JesseYan8/LPDA/LPDA_Mount_V1_3_Hybrid_P2S/LPDA_Mount_V1_3_Hybrid/OPTIONAL_TPU/README_zh.md

仅是软垫的可选制造方式，可用尺寸相同的柔软硅胶片替代。
不要用PETG打印这些软垫。尼龙M3螺钉、螺母、垫圈必须使用购买的成品，不属于这组文件。
S01×8，S02×4，S03×16，S04×4。打印软垫未做实际验证。
