JesseYan8/LPDA/LPDA_Mount_V1_3_Hybrid_P2S/LPDA_Mount_V1_3_Hybrid/preview/01_structure.png

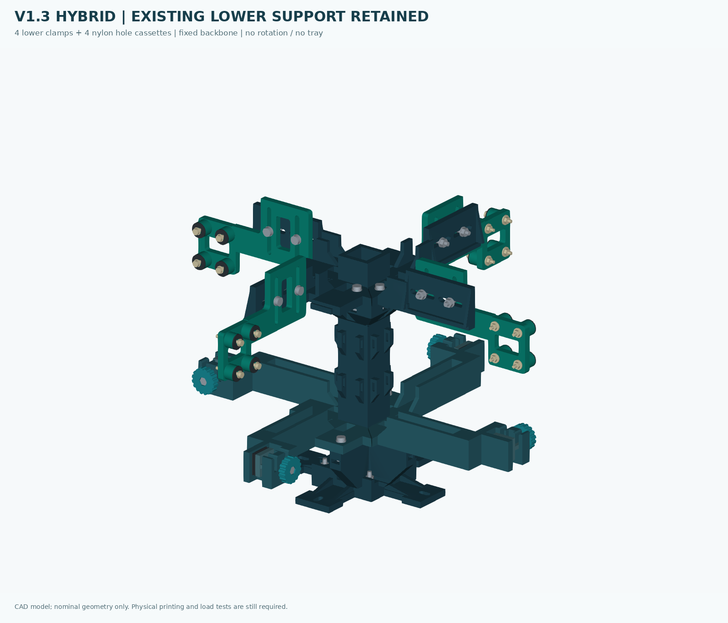
LPDA_Mount_V1_3_Hybrid_P2S/LPDA_Mount_V1_3_Hybrid/preview/01_structure.png
