JesseYan8/LPDA/LPDA_Mount_V1_3_Hybrid_P2S/LPDA_Mount_V1_3_Hybrid/preview/03_single_sector.png

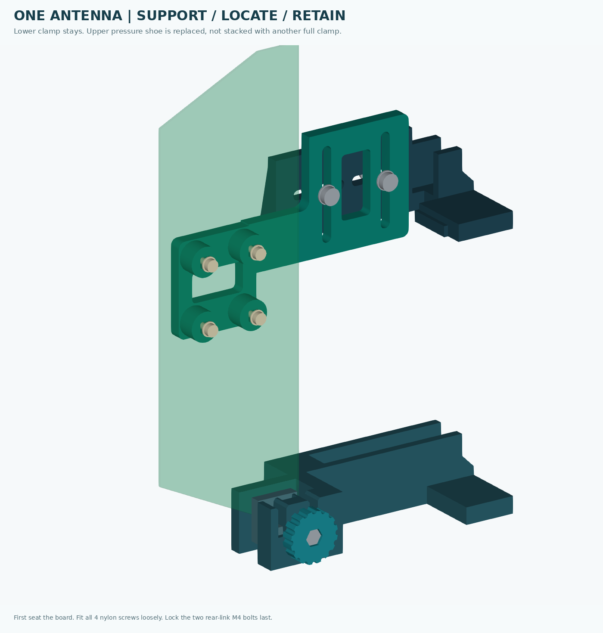
LPDA_Mount_V1_3_Hybrid_P2S/LPDA_Mount_V1_3_Hybrid/preview/03_single_sector.png
