JesseYan8/LPDA/LPDA_Mount_V1_3_Hybrid_P2S/LPDA_Mount_V1_3_Hybrid/preview/05_cassette_face.png

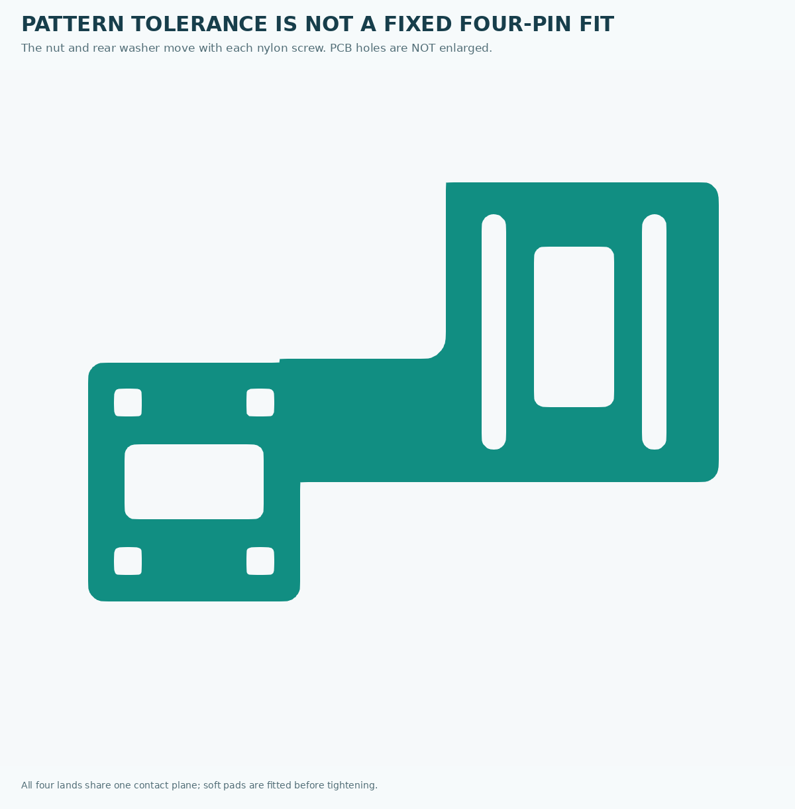
LPDA_Mount_V1_3_Hybrid_P2S/LPDA_Mount_V1_3_Hybrid/preview/05_cassette_face.png
