JesseYan8/LPDA/LPDA_Mount_V1_3_Hybrid_P2S/LPDA_Mount_V1_3_Hybrid/preview/FULL_01_LOWER_REUSED.png

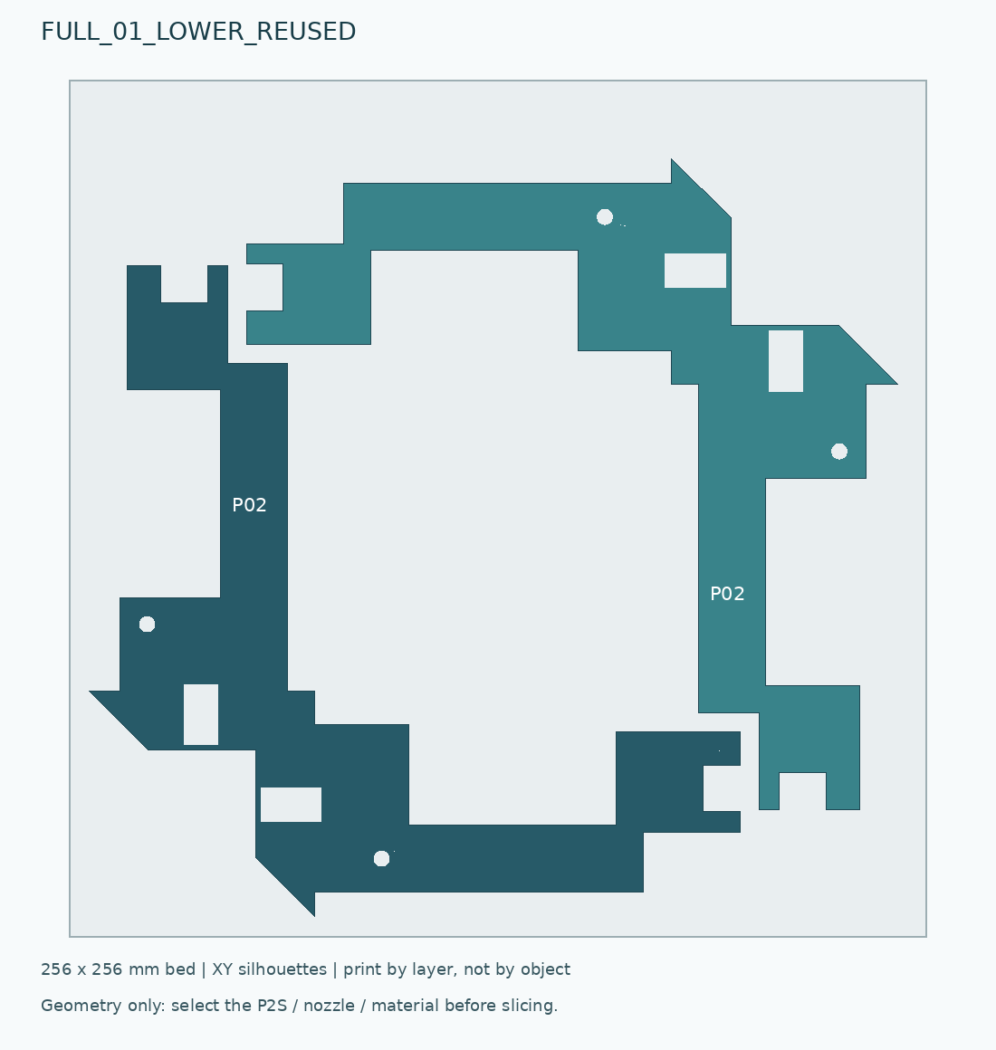
LPDA_Mount_V1_3_Hybrid_P2S/LPDA_Mount_V1_3_Hybrid/preview/FULL_01_LOWER_REUSED.png
