JesseYan8/LPDA/LPDA_Mount_V1_3_Hybrid_P2S/LPDA_Mount_V1_3_Hybrid/preview/FULL_03_REUSED_MAST_BASE_SMALL.png

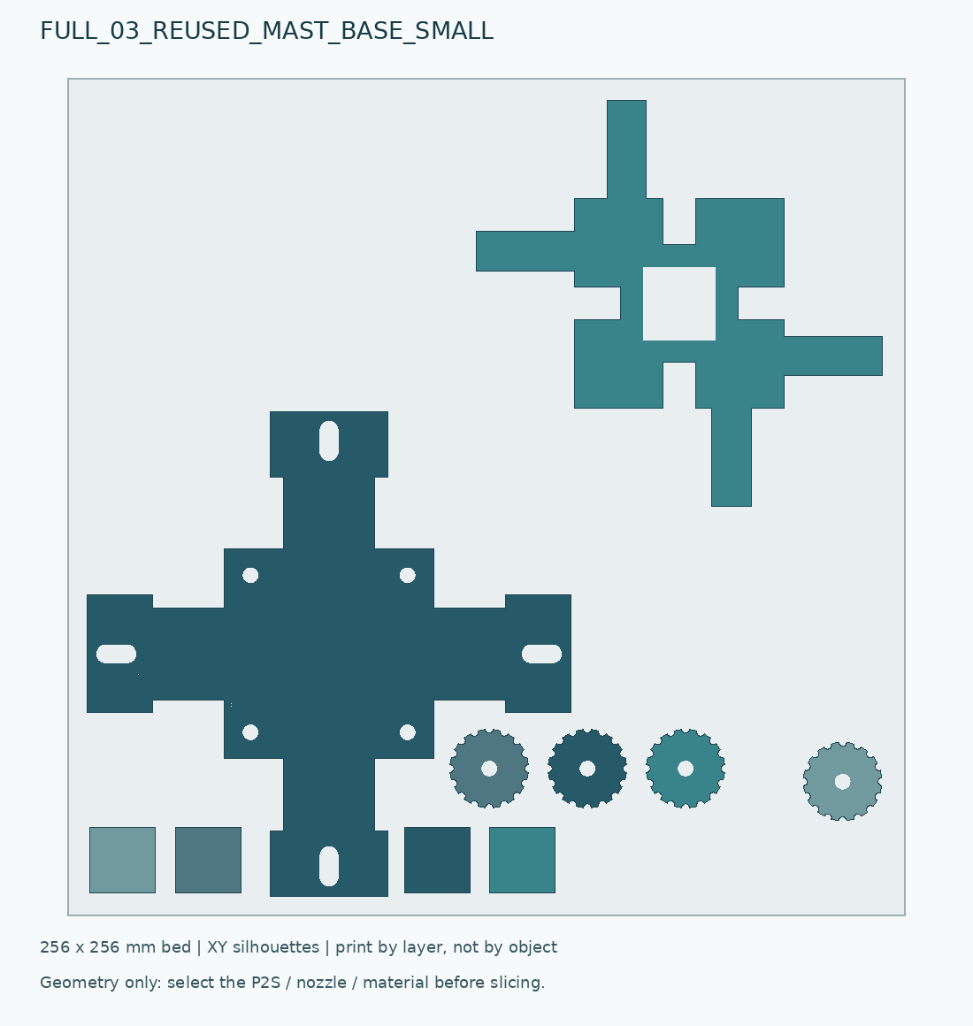
LPDA_Mount_V1_3_Hybrid_P2S/LPDA_Mount_V1_3_Hybrid/preview/FULL_03_REUSED_MAST_BASE_SMALL.png
