JesseYan8/LPDA/LPDA_Mount_V1_3_Hybrid_P2S/LPDA_Mount_V1_3_Hybrid/plates/FULL_02_UPPER.3mf

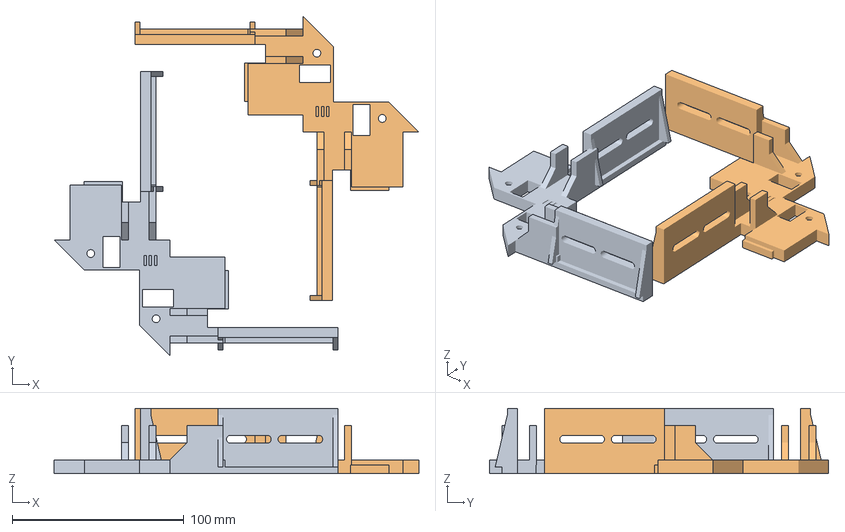
[picture p10: CAD file, 2026-09-13]
LPDA_Mount_V1_3_Hybrid_P2S/LPDA_Mount_V1_3_Hybrid/plates/FULL_02_UPPER.3mf
212.4 x 197.4 x 38.0 mm
P01_upper_carrier_1
P01_upper_carrier_2
