JesseYan8/LPDA/LPDA_Mount_V1_3_Hybrid_P2S/LPDA_Mount_V1_3_Hybrid/plates/FULL_04_CASSETTES.3mf

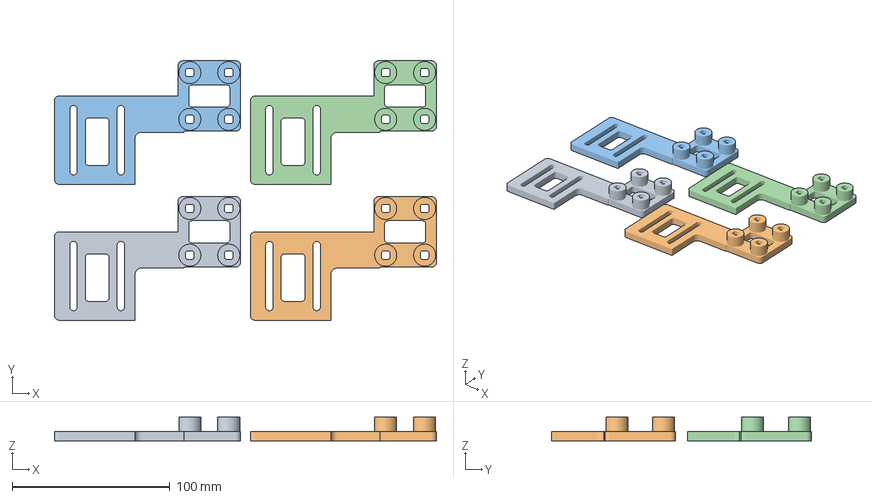
[picture p11: CAD file, 2026-09-13]
LPDA_Mount_V1_3_Hybrid_P2S/LPDA_Mount_V1_3_Hybrid/plates/FULL_04_CASSETTES.3mf
241.8 x 164.3 x 15.0 mm
P07_four_hole_cassette_1
P07_four_hole_cassette_2
P07_four_hole_cassette_3
P07_four_hole_cassette_4
