JesseYan8/LPDA/LPDA_Mount_V1_3_Hybrid_P2S/LPDA_Mount_V1_3_Hybrid/plates/FULL_03_REUSED_MAST_BASE_SMALL.3mf

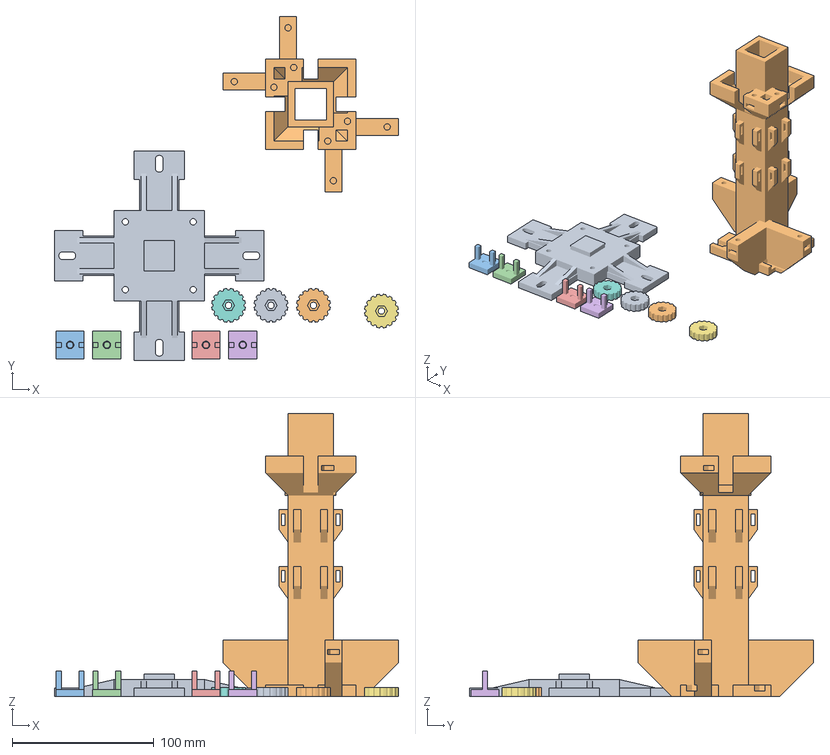
[picture p12: CAD file, 2026-09-13]
LPDA_Mount_V1_3_Hybrid_P2S/LPDA_Mount_V1_3_Hybrid/plates/FULL_03_REUSED_MAST_BASE_SMALL.3mf
243.0 x 243.0 x 200.0 mm
P04_anchor_base_1
P03_fixed_mast_1
P05_pressure_shoe_1
P05_pressure_shoe_2
P05_pressure_shoe_3
P05_pressure_shoe_4
P06_M4_knob_1
P06_M4_knob_2
P06_M4_knob_3
P06_M4_knob_4
