JesseYan8/LPDA/LPDA_Mount_V1_3_Hybrid_P2S/LPDA_Mount_V1_3_Hybrid/plates/FULL_01_LOWER_REUSED.3mf

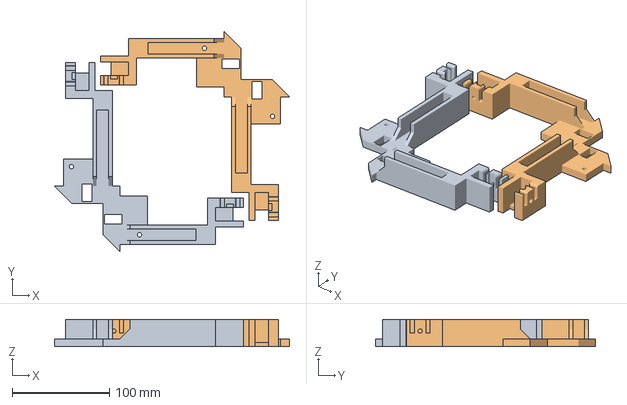
[picture p13: CAD file, 2026-09-13]
LPDA_Mount_V1_3_Hybrid_P2S/LPDA_Mount_V1_3_Hybrid/plates/FULL_01_LOWER_REUSED.3mf
241.4 x 226.4 x 28.0 mm
P02_lower_half_1
P02_lower_half_2
