JesseYan8/LPDA/LPDA_Mount_V1_3_Hybrid_P2S/LPDA_Mount_V1_3_Hybrid/STEP/LPDA_V1_3_assembly.step

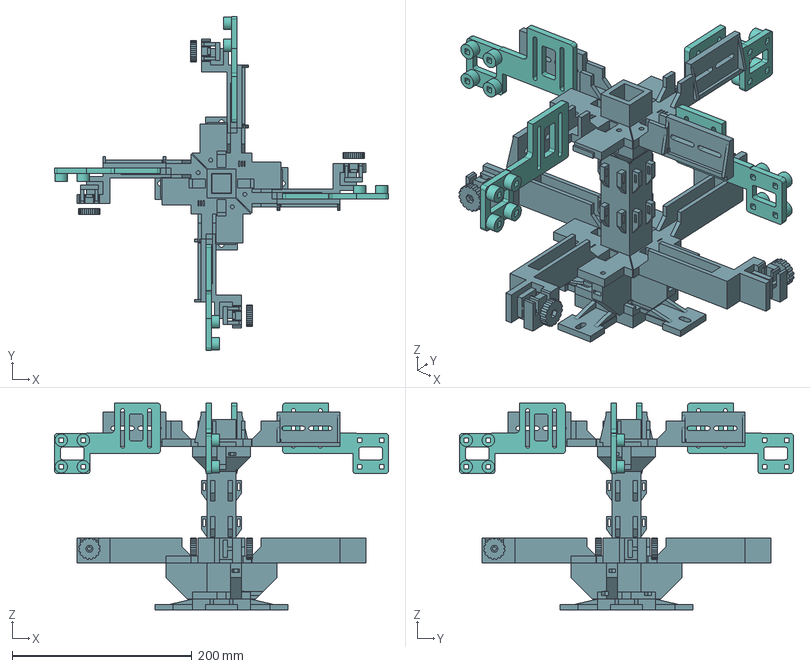
[picture p14: CAD file, 2026-09-13]
LPDA_Mount_V1_3_Hybrid_P2S/LPDA_Mount_V1_3_Hybrid/STEP/LPDA_V1_3_assembly.step
371.7 x 371.7 x 230.0 mm
anchor_base
fixed_mast
lower_half_0
lower_half_180
shoe_40_0
knob_40_0
shoe_40_90
knob_40_90
shoe_40_180
knob_40_180
shoe_40_270
knob_40_270
upper_carrier_0
upper_carrier_180
cassette_0
cassette_90
cassette_180
cassette_270
