JesseYan8/LPDA/LPDA_Mount_V1_3_Hybrid_P2S/LPDA_Mount_V1_3_Hybrid/OPTIONAL_TPU/S02_lower_seat_18x14x2.stl

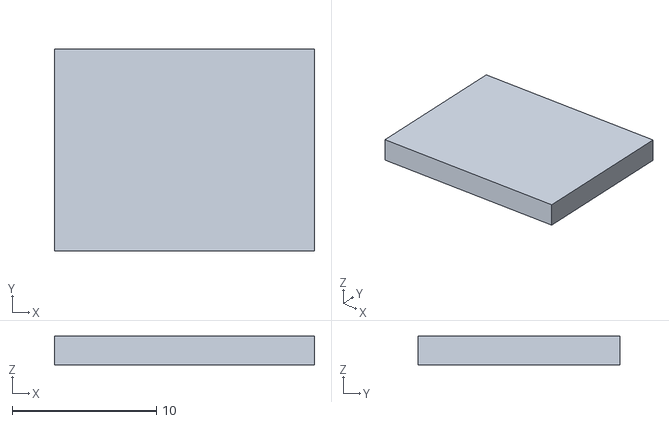
[picture p15: CAD file, 2026-09-13]
LPDA_Mount_V1_3_Hybrid_P2S/LPDA_Mount_V1_3_Hybrid/OPTIONAL_TPU/S02_lower_seat_18x14x2.stl
18.0 x 14.0 x 2.00
