JesseYan8/LPDA/LPDA_Mount_V1_3_Hybrid_P2S/LPDA_Mount_V1_3_Hybrid/plates/FIRST_FIT_CASSETTE_NOT_LOAD_TEST.3mf

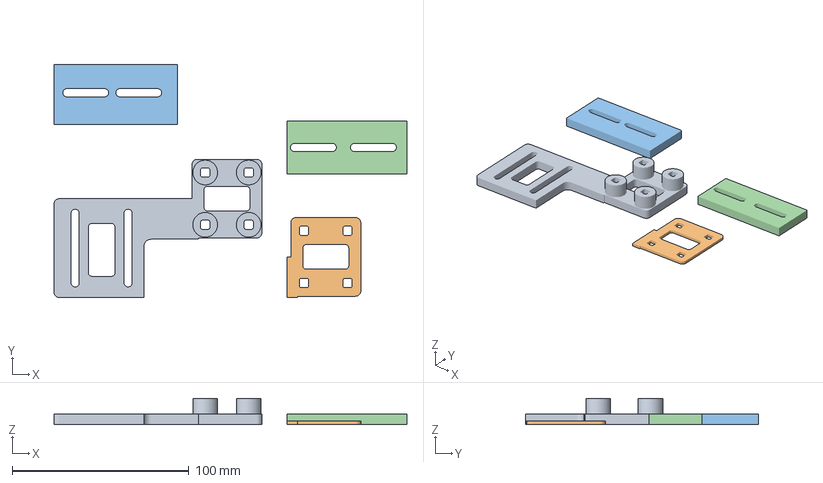
[picture p16: CAD file, 2026-09-13]
LPDA_Mount_V1_3_Hybrid_P2S/LPDA_Mount_V1_3_Hybrid/plates/FIRST_FIT_CASSETTE_NOT_LOAD_TEST.3mf
200.0 x 132.0 x 15.0 mm
P07_four_hole_cassette_1
T01_hole_pattern
T03_carrier_fit
T02_M4_slot_fit
