JesseYan8/LPDA/LPDA_Mount_V1_3_Hybrid_P2S/LPDA_Mount_V1_3_Hybrid/reference/v121/P02_lower_half.step

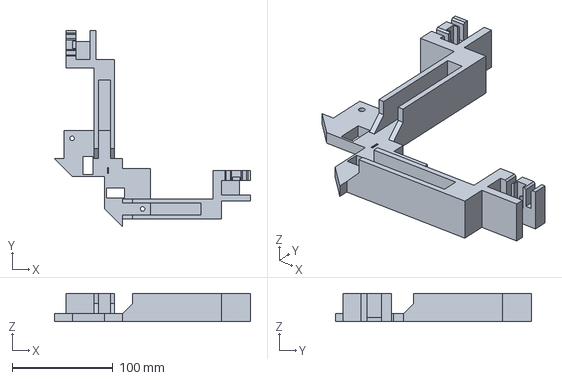
[picture p17: CAD file, 2026-09-13]
LPDA_Mount_V1_3_Hybrid_P2S/LPDA_Mount_V1_3_Hybrid/reference/v121/P02_lower_half.step
194.4 x 194.4 x 28.0 mm
