JesseYan8/LPDA/LPDA_Mount_V1_3_Hybrid_P2S/LPDA_Mount_V1_3_Hybrid/STL/P07_four_hole_cassette_x4_spread_256.stl

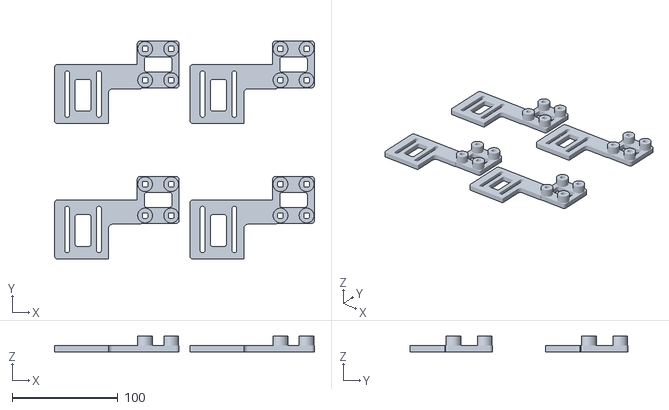
[picture p18: CAD file, 2026-09-16]
LPDA_Mount_V1_3_Hybrid_P2S/LPDA_Mount_V1_3_Hybrid/STL/P07_four_hole_cassette_x4_spread_256.stl
245.8 x 206.3 x 15.0
