JesseYan8/LPDA/LPDA_Mount_V1_3_Hybrid_P2S/LPDA_Mount_V1_3_Hybrid/OPTIONAL_TPU/S03_hole_land_OD14_T1.stl

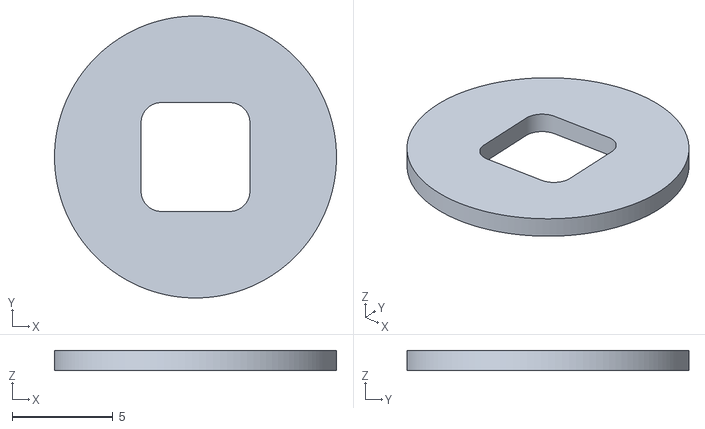
[picture p19: CAD file, 2026-09-13]
LPDA_Mount_V1_3_Hybrid_P2S/LPDA_Mount_V1_3_Hybrid/OPTIONAL_TPU/S03_hole_land_OD14_T1.stl
14.0 x 14.0 x 1.00
