JesseYan8/LPDA/LPDA_Mount_V1_3_Hybrid_P2S/LPDA_Mount_V1_3_Hybrid/reference/v121/P05_pressure_shoe.step

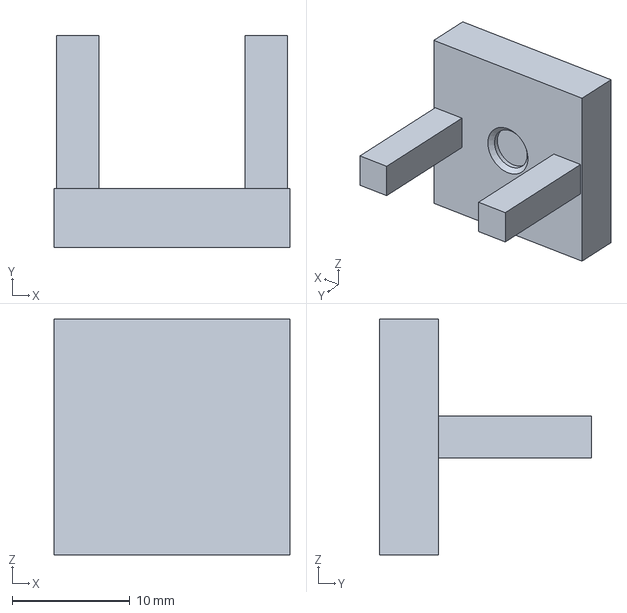
[picture p20: CAD file, 2026-09-13]
LPDA_Mount_V1_3_Hybrid_P2S/LPDA_Mount_V1_3_Hybrid/reference/v121/P05_pressure_shoe.step
20.0 x 18.0 x 20.0 mm
