JesseYan8/LPDA/LPDA_Mount_V1_3_Hybrid_P2S/LPDA_Mount_V1_3_Hybrid/STEP/P01_upper_carrier.step

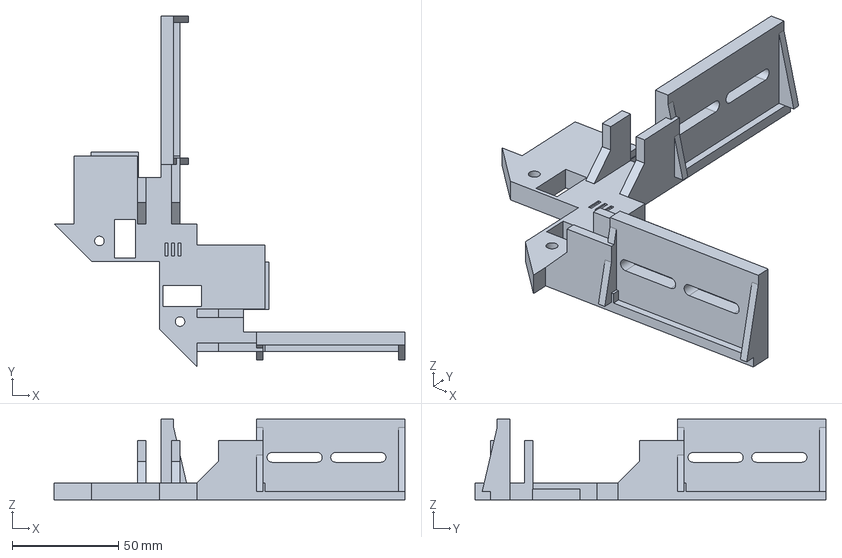
[picture p21: CAD file, 2026-09-13]
LPDA_Mount_V1_3_Hybrid_P2S/LPDA_Mount_V1_3_Hybrid/STEP/P01_upper_carrier.step
165.4 x 165.4 x 38.0 mm
