JesseYan8/LPDA/LPDA_Mount_V1_3_Hybrid_P2S/LPDA_Mount_V1_3_Hybrid/STL/P06_M4_knob_x4_spread_256.stl

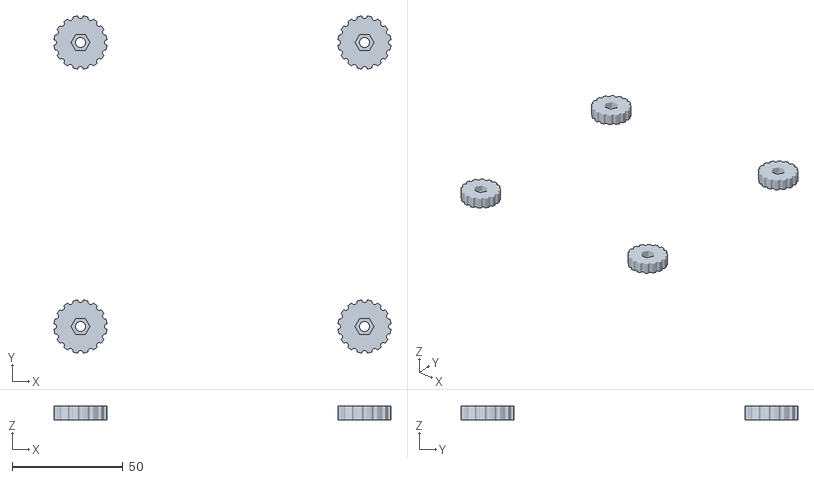
[picture p22: CAD file, 2026-09-16]
LPDA_Mount_V1_3_Hybrid_P2S/LPDA_Mount_V1_3_Hybrid/STL/P06_M4_knob_x4_spread_256.stl
151.9 x 151.9 x 6.40
