JesseYan8/LPDA/LPDA_Mount_V1_3_Hybrid_P2S/LPDA_Mount_V1_3_Hybrid/OPTIONAL_TPU/S04_cable_pad_22x8x1.stl

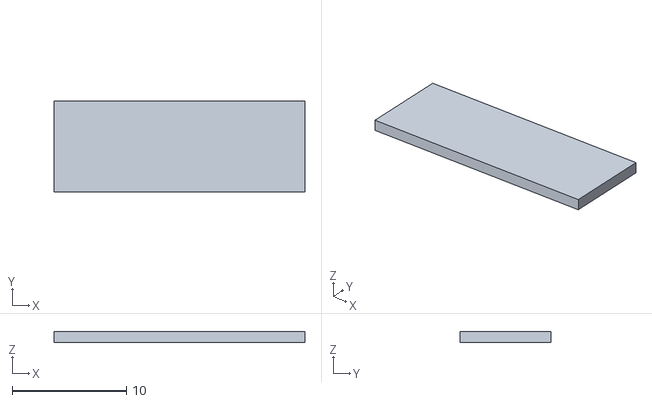
[picture p23: CAD file, 2026-09-13]
LPDA_Mount_V1_3_Hybrid_P2S/LPDA_Mount_V1_3_Hybrid/OPTIONAL_TPU/S04_cable_pad_22x8x1.stl
22.0 x 8.00 x 1.00
