JesseYan8/LPDA/LPDA_Mount_V1_3_Hybrid_P2S/LPDA_Mount_V1_3_Hybrid/reference/v121/P04_anchor_base.step

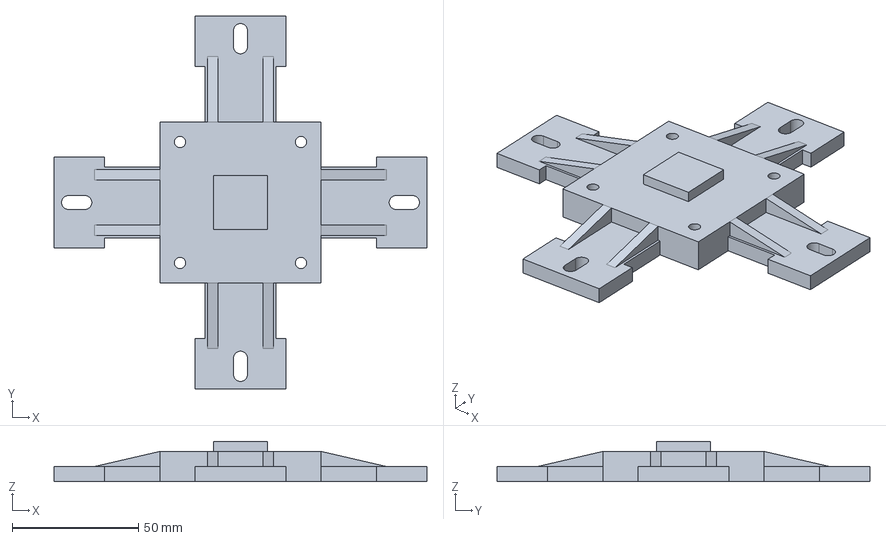
[picture p24: CAD file, 2026-09-13]
LPDA_Mount_V1_3_Hybrid_P2S/LPDA_Mount_V1_3_Hybrid/reference/v121/P04_anchor_base.step
148.0 x 148.0 x 16.0 mm
