JesseYan8/LPDA/LPDA_Mount_V1_3_Hybrid_P2S/LPDA_Mount_V1_3_Hybrid/STL/P05_pressure_shoe_x4_spread_256.stl

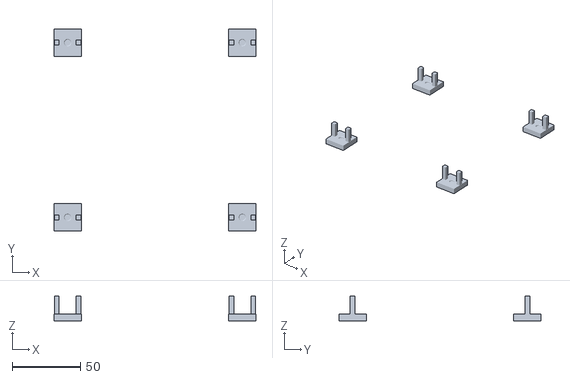
[picture p25: CAD file, 2026-09-16]
LPDA_Mount_V1_3_Hybrid_P2S/LPDA_Mount_V1_3_Hybrid/STL/P05_pressure_shoe_x4_spread_256.stl
148.0 x 148.0 x 18.0
