JesseYan8/LPDA/LPDA_Mount_V1_3_Hybrid_P2S/LPDA_Mount_V1_3_Hybrid/OPTIONAL_TPU/S01_lower_face_20x20x1.stl

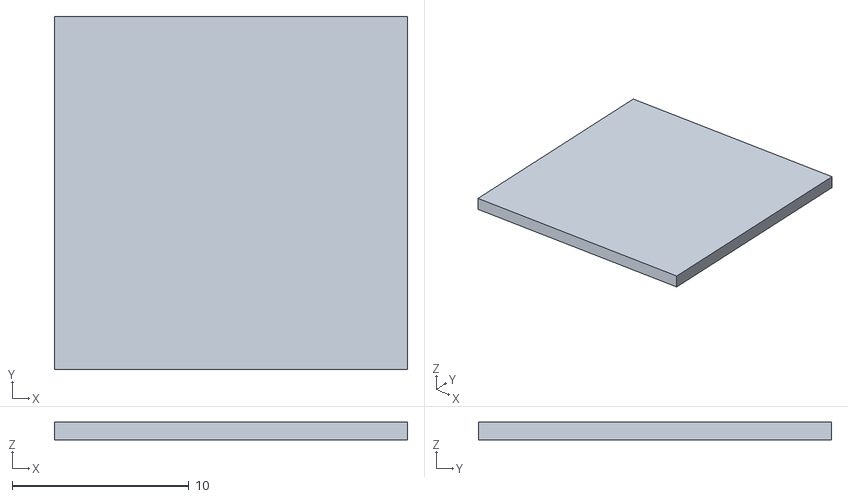
[picture p26: CAD file, 2026-09-13]
LPDA_Mount_V1_3_Hybrid_P2S/LPDA_Mount_V1_3_Hybrid/OPTIONAL_TPU/S01_lower_face_20x20x1.stl
20.0 x 20.0 x 1.00
