JesseYan8/LPDA/LPDA_Mount_V1_3_Hybrid_P2S/LPDA_Mount_V1_3_Hybrid/reference/v121/P06_M4_knob.step

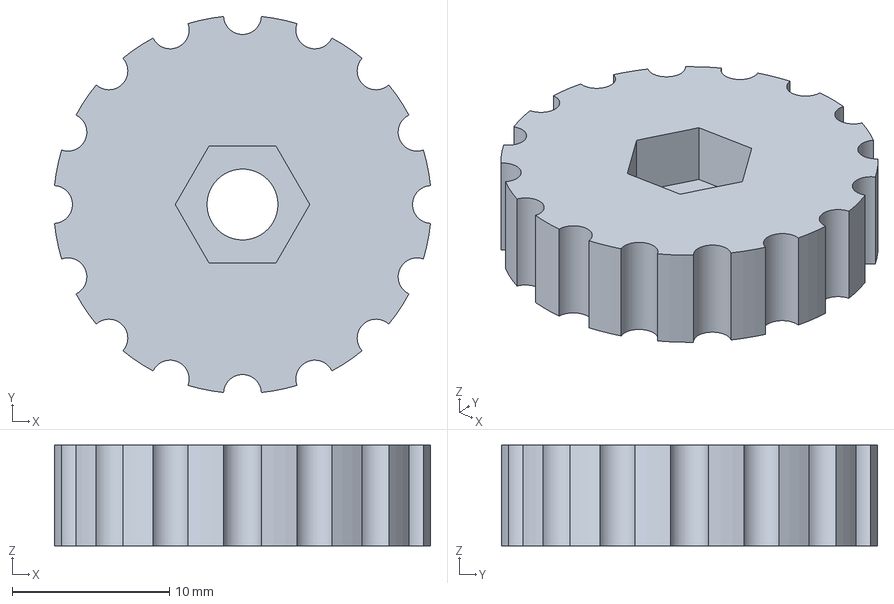
[picture p27: CAD file, 2026-09-13]
LPDA_Mount_V1_3_Hybrid_P2S/LPDA_Mount_V1_3_Hybrid/reference/v121/P06_M4_knob.step
23.9 x 23.9 x 6.40 mm
