JesseYan8/LPDA/LPDA_Mount_V1_3_Hybrid_P2S/LPDA_Mount_V1_3_Hybrid/STEP/P07_four_hole_cassette.step

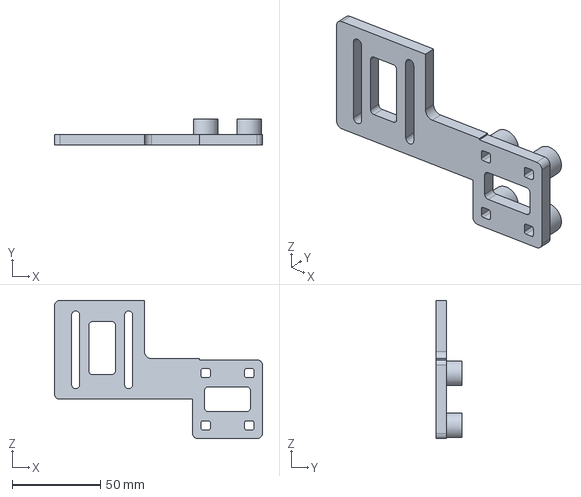
[picture p28: CAD file, 2026-09-13]
LPDA_Mount_V1_3_Hybrid_P2S/LPDA_Mount_V1_3_Hybrid/STEP/P07_four_hole_cassette.step
117.8 x 15.0 x 78.3 mm
