JesseYan8/LPDA/LPDA_Mount_V1_3_Hybrid_P2S/LPDA_Mount_V1_3_Hybrid/STL/T01_hole_pattern.stl

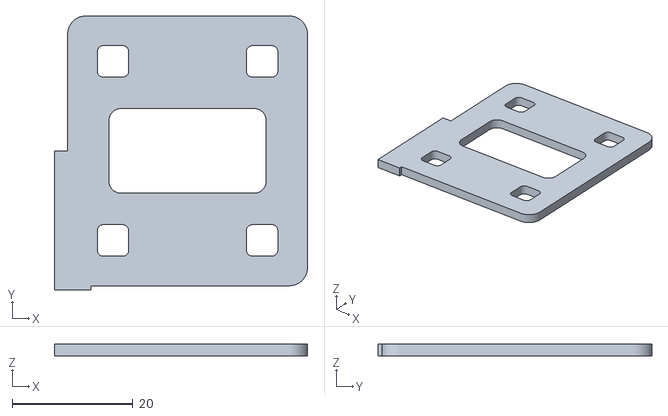
[picture p29: CAD file, 2026-09-13]
LPDA_Mount_V1_3_Hybrid_P2S/LPDA_Mount_V1_3_Hybrid/STL/T01_hole_pattern.stl
41.8 x 45.3 x 2.00
