JesseYan8/LPDA/LPDA_Mount_V1_3_Hybrid_P2S/LPDA_Mount_V1_3_Hybrid/reference/v121/P03_fixed_mast.step

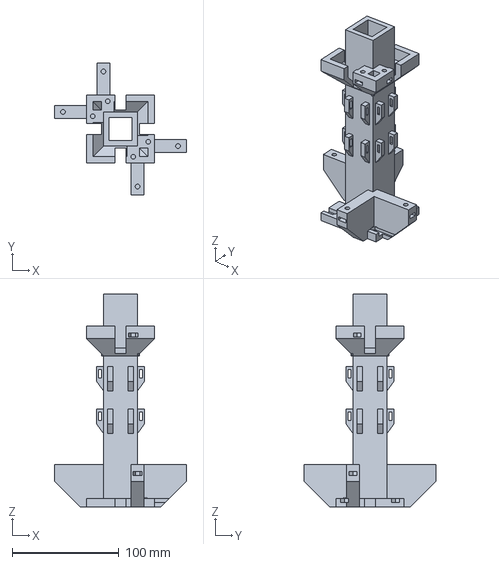
[picture p30: CAD file, 2026-09-13]
LPDA_Mount_V1_3_Hybrid_P2S/LPDA_Mount_V1_3_Hybrid/reference/v121/P03_fixed_mast.step
124.0 x 124.0 x 200.0 mm
