JesseYan8/LPDA/LPDA_Mount_V1_3_Hybrid_P2S/LPDA_Mount_V1_3_Hybrid/STL/T02_M4_slot_fit.stl

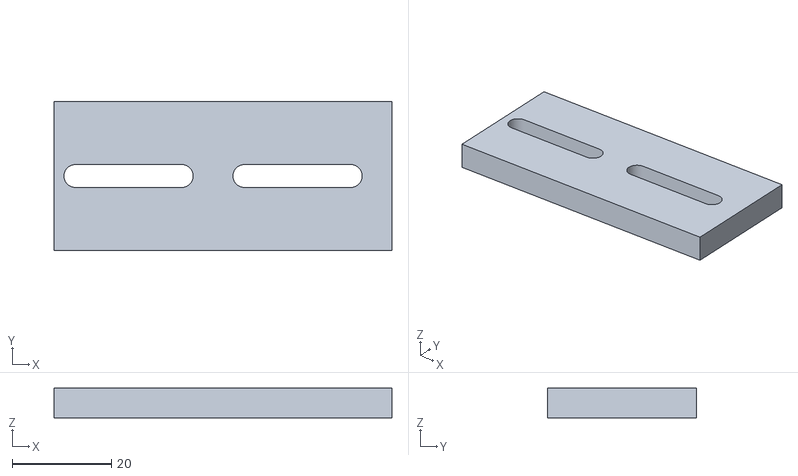
[picture p31: CAD file, 2026-09-13]
LPDA_Mount_V1_3_Hybrid_P2S/LPDA_Mount_V1_3_Hybrid/STL/T02_M4_slot_fit.stl
68.0 x 30.0 x 6.00
