JesseYan8/LPDA/LPDA_Mount_V1_3_Hybrid_P2S/LPDA_Mount_V1_3_Hybrid/STEP/LPDA_V1_3_visual_reference_NOT_MEASURED.step

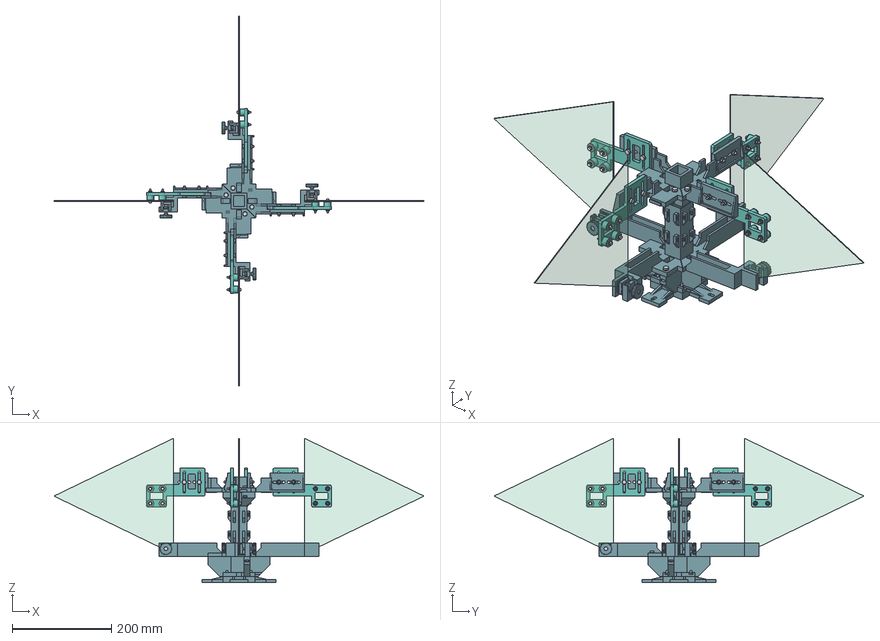
[picture p33: CAD file, 2026-09-13]
LPDA_Mount_V1_3_Hybrid_P2S/LPDA_Mount_V1_3_Hybrid/STEP/LPDA_V1_3_visual_reference_NOT_MEASURED.step
744.0 x 744.0 x 290.0 mm
anchor_base
fixed_mast
lower_half_0
lower_half_180
shoe_40_0
knob_40_0
shoe_40_90
knob_40_90
shoe_40_180
knob_40_180
shoe_40_270
knob_40_270
upper_carrier_0
upper_carrier_180
cassette_0
cassette_90
cassette_180
cassette_270
base_-24_-24_bolt
base_-24_-24_washer
base_-24_-24_nut
base_-24_24_bolt
base_-24_24_washer
base_-24_24_nut
base_24_-24_bolt
base_24_-24_washer
base_24_-24_nut
base_24_24_bolt
base_24_24_washer
base_24_24_nut
frame_40_0_bolt
frame_40_0_washer
frame_40_0_nut
frame_40_1_bolt
frame_40_1_washer
frame_40_1_nut
frame_40_2_bolt
frame_40_2_washer
frame_40_2_nut
frame_40_3_bolt
frame_40_3_washer
frame_40_3_nut
clamp_40_0_bolt
clamp_40_0_nut
clamp_40_0_retaining_nut
clamp_40_90_bolt
clamp_40_90_nut
clamp_40_90_retaining_nut
clamp_40_180_bolt
clamp_40_180_nut
clamp_40_180_retaining_nut
clamp_40_270_bolt
clamp_40_270_nut
clamp_40_270_retaining_nut
frame_170_0_bolt
frame_170_0_washer
frame_170_0_nut
frame_170_1_bolt
frame_170_1_washer
frame_170_1_nut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
