JesseYan8/LPDA/LPDA_Mount_V1_3_Hybrid_P2S/LPDA_Mount_V1_3_Hybrid/Validation_V1_3_zh.html

SPECTRUM_SENSING / LPDA MOUNT V1.3 HYBRID / 2026-09-12

# V1.3 实际几何与装配复核记录

当前几何脚本未检出失败项。该结论仅覆盖下面明确列出的模型、工具包络、位置与运动检查，不是已打印实物或结构标准认证。

复核对象是本次发布的实际 STL/STEP/3MF 与源代码，不是只看渲染图。旧 V1.2.1 参考 STEP 一并放在 reference/v121，便于独立确认哪些实体被保留。

## 1. 设计过程中修正的干涉

首个混合草案的原馈线桥与新安装板及其下落路线重叠。已在局部梁中让出移动通道，并把软绑带桥移向中央，最后重跑静态、位置及落入检查。两个 M4 补偿槽使用闭口结构，端部及螺栓列保留连续材料；删除右上方无用面料时未删除两螺栓列及下部承力带。

## 2. 已实际执行的项目

项目 | 覆盖范围 | 结果与解释
静态装配 | 7种打印几何及装配五金／软垫 | 非预期正体积相交为0；判断阈值0.03 mm³
局部孔余量 | 4孔×9偏置=36组 | M3杆与窗口无干涉；OD9背垫圈最小名义承压接触面积约37.44 mm²
整板安装余量 | x=-10/0/+10、z=-18/0/+18，共9组 | 安装板、M4杆、后垫圈／螺母空间无检出干涉
新增螺丝刀 | 8组M4接口＋16组M3，24组 | 示例相邻PCB已装；名义位置下杆／手柄无碰撞
沿用结构工具 | 12结构位置×2工具规格，24组 | 依照底座→下框→上框的分阶段顺序检查
下夹压块 | 4方向×4位置，16个保守扫掠包络 | 旧顶装压块路线在新上框存在时无碰撞
尼龙螺母入口 | 16个背向进入保守扫掠 | 外形扫掠无碰撞；不等同真实手指／扳手握持
PCB连安装板落入 | 4方向×6高度，24个采样姿态 | 含预装尼龙五金与孔周软垫；另三副完整示例天线已装，目标下夹退开2 mm，无检出碰撞；不是连续无碰撞证明
单安装板落入 | 0…120 mm，5 mm间隔 | 一方向代表例无碰撞，依对称复制；不含任意新板形
M3螺钉长度 | 6种名义板厚 | 全厚螺母均覆盖，最小余长1.1 mm
示例RF线 | 4mm直径，固定分段路线 | 未检出打印结构干涉；最小弯曲半径未验证
网格/STEP | 7种STL，18件STEP回读 | 封闭、法向一致、单连通；回读实体与源几何体积一致
复用件 | 5类原版STEP与新几何双向差 | 对称几何差为0；确认V1.2.1复用，不是更早版
3MF | 4张正式板＋2张试装板 | 独立回读数量与位置；正式18件，平面投影不重叠

孔周37.44 mm²是垫圈与打印座名义重叠面积，不是尼龙垫圈允许承压、弯曲挠度或额定载荷。大范围位置、局部孔偏差和工具检查并未穷举所有组合；打印收缩、实际孔斜度与任意PCB轮廓不包含在这些离散检查里。

## 3. 相邻天线与手工装配

工具检查含占位 PCB，安装板 M4 螺钉布置在后缘内侧，避免螺丝刀必须穿过自己的天线板。四孔尼龙件建议在台面先装，因此不依赖手在狭窄中央空间内拿住四个小螺母。安装板背面的螺母通道开放，未把可变孔位重新锁死。

采用已知阶段顺序不代表任意顺序都可装。底座底部螺钉须先装再锚固，下框结构须先锁再装上框。不能声称上层带载时仍可自由维修下层。

## 4. 尚未验证

未执行 Bambu Studio 实际切片、支撑生成、打印首件、有限元分析、夹紧力／拉脱力、长期蠕变、跌落、风载或RF性能测试。没有额定承载数值，没有保证任意硬度尼龙或任意线径均兼容。实际孔径和孔组相对下缘／后缘仍需实物核对。

下一步只放行小样／单副首装：T01自然穿孔；实际P07落座范围匹配；所有螺母／垫圈有正确接触；下托不悬空；PCB不弯；轻微扰动后无滑转；下游拉线不传到SMA。通过后才复制四路。使用过程中按观察结果决定复紧，不给出没有试验依据的周期和扭矩。

## 5. 数据与复现

文件 | 内容
geometry.json | 网格、数量、尺寸、实体体积
fasteners.json | 40组螺钉的名义轴向连接
audit.json | 孔位余量、位置、工具、落入与堆叠
assembly_stages.json | 原结构工具、下夹入口、螺母入口、STEP复用
cable_route.json | 4mm示例线径路线
plates.json | 实际3MF回读与投影间距

完整结构 STL 实体体积约 841.7 cm³；几何体积不等于实际耗材。请勿把本报告的“0个几何失败项”转述成“已通过工程认证”。
