JesseYan8/LPDA/LPDA_Mount_V1_3_Hybrid_P2S/LPDA_Mount_V1_3_Hybrid/preview/FIRST_FIT_CASSETTE_NOT_LOAD_TEST.png

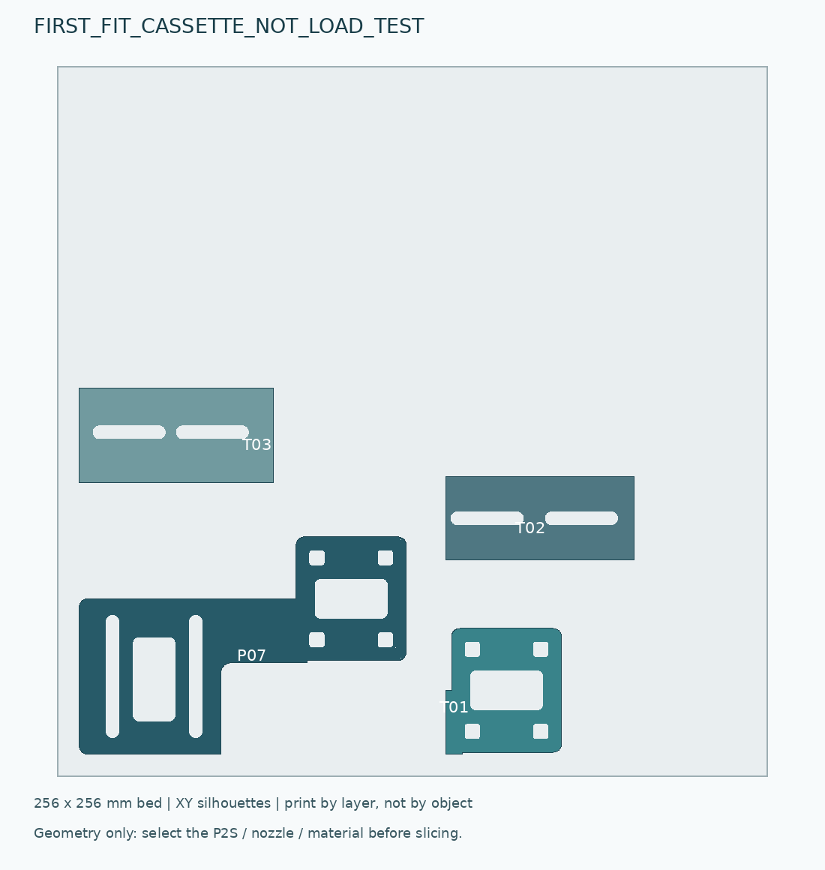
LPDA_Mount_V1_3_Hybrid_P2S/LPDA_Mount_V1_3_Hybrid/preview/FIRST_FIT_CASSETTE_NOT_LOAD_TEST.png
